Chihhao/Arduino_Oil_Meter_Gps/image/p3.png

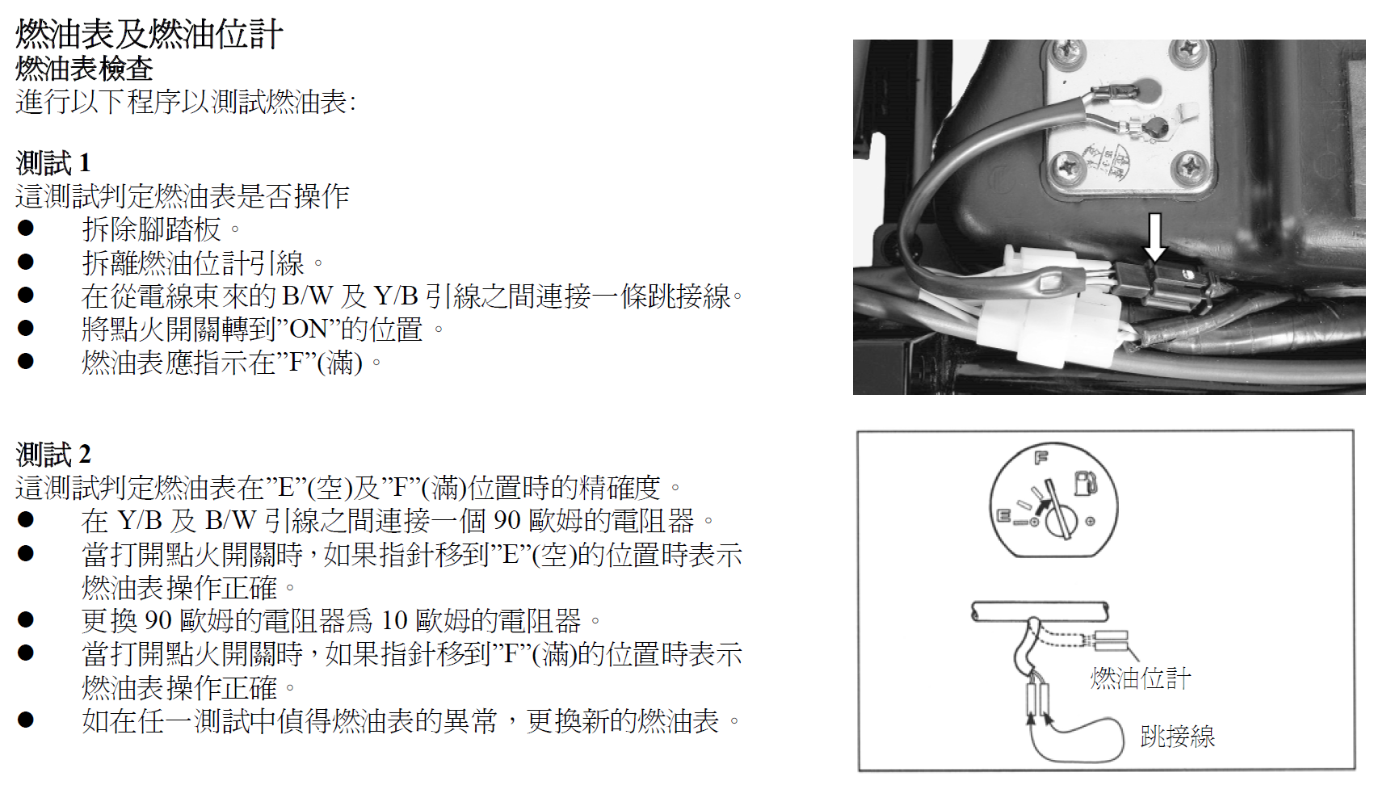
image/p3.png
